VectorSix/HF-ICT_IoT_Switcher/README.md

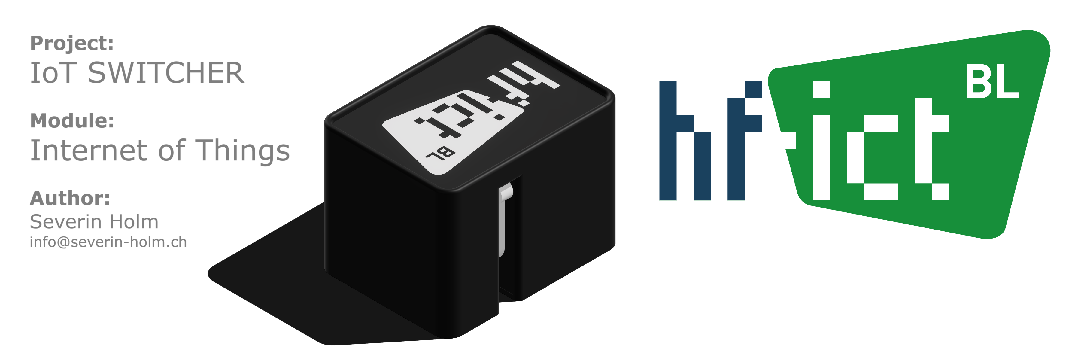
[picture p1: images/Git_Logo.png]
GitHub_Readme_Logo
