VectorSix/HF-ICT_IoT_Switcher/documentation/GitRepo.docx

SWITCHER

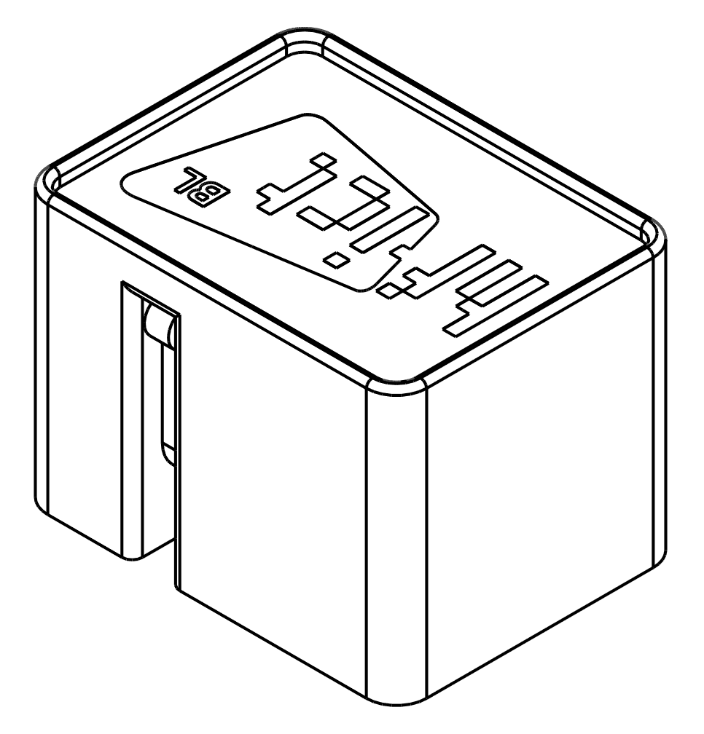
[picture p2: figure]

Scan code for instructions

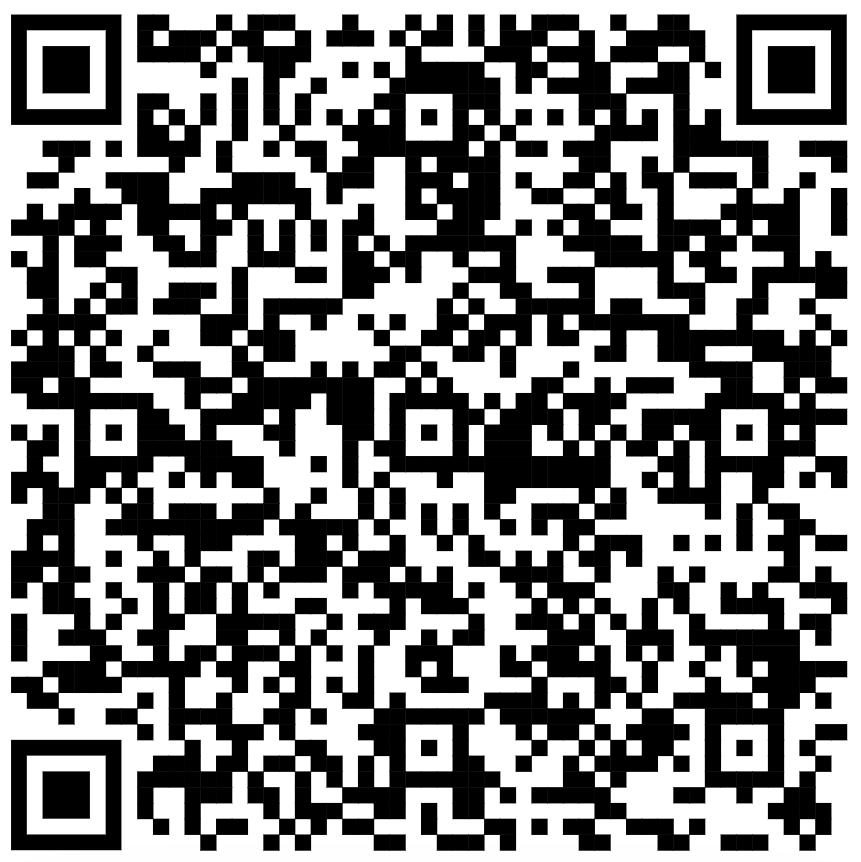
[picture p3: figure]

https://github.com/VectorSix/HF-ICT_IoT_Switcher

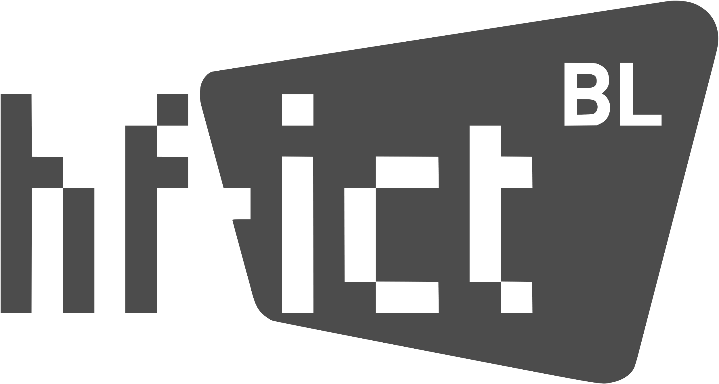
[picture p4: figure]

2025 BY SEVERIN HOLM – HF-ICT – IOT 2 BUILD MANUAL V.1.0
