VectorSix/HF-ICT_IoT_Switcher/flasher/assets/devices/iot_switcher/product.png

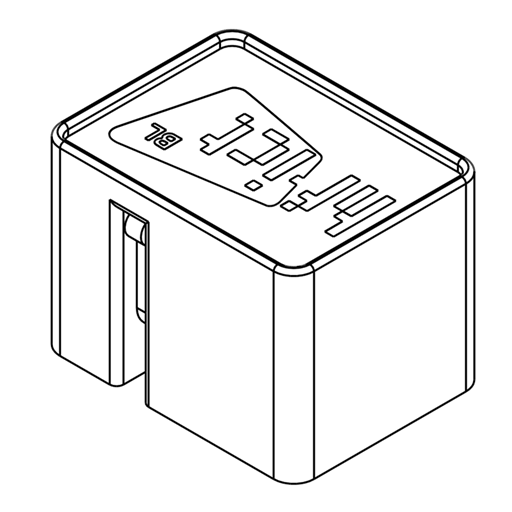
flasher/assets/devices/iot_switcher/product.png
