VectorSix/HF-ICT_IoT_Switcher/images/Case.png

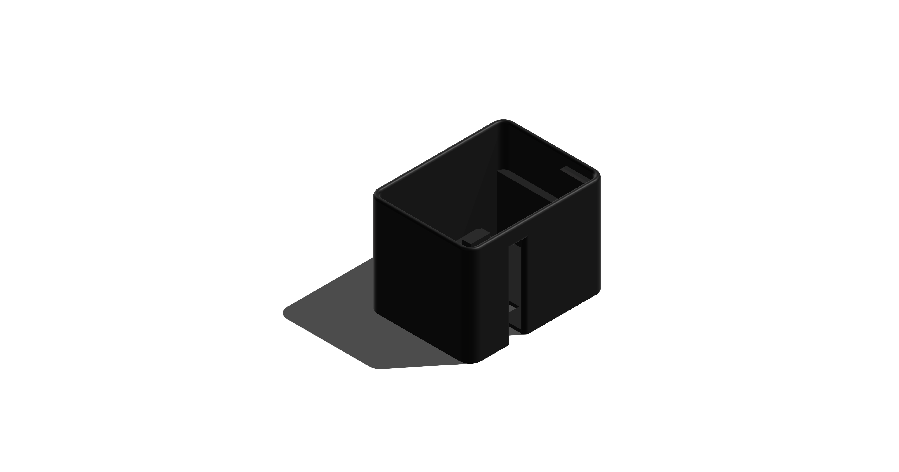
images/Case.png
