VectorSix/HF-ICT_IoT_Switcher/images/Closer.png

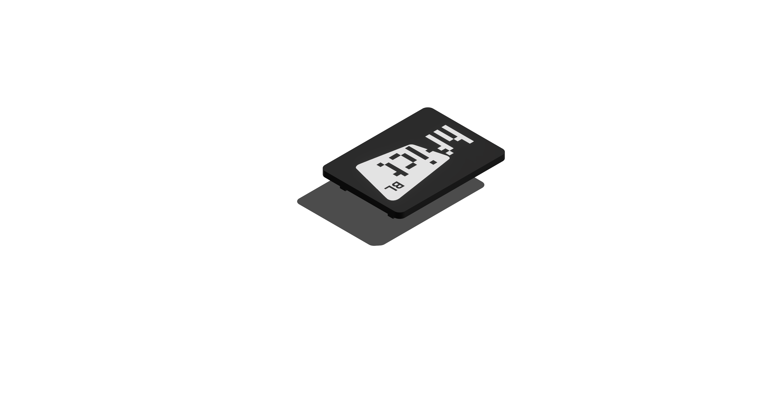
images/Closer.png
