VectorSix/HF-ICT_IoT_Switcher/images/Finger.png

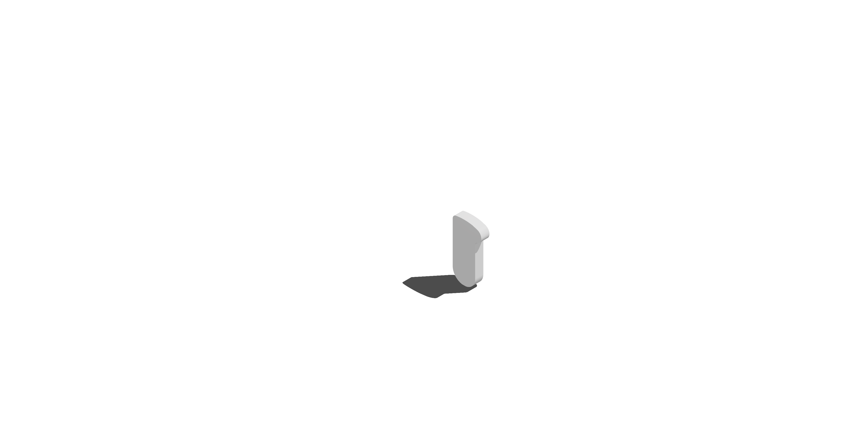
images/Finger.png
