VectorSix/HF-ICT_IoT_Switcher/images/OPEN_0.png

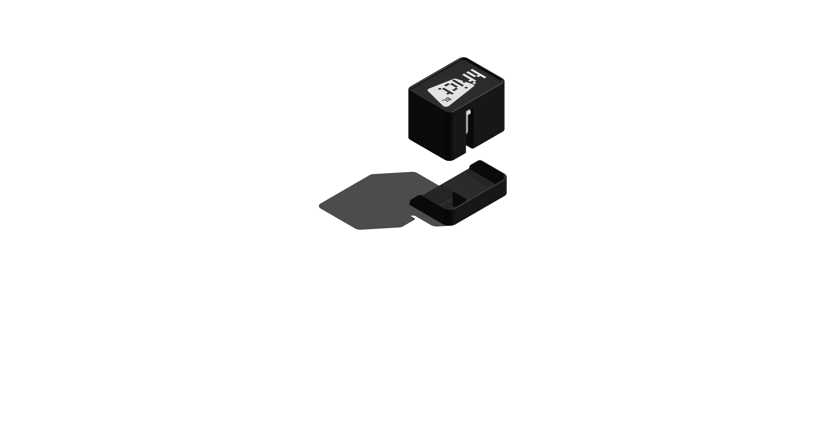
images/OPEN_0.png
