VectorSix/HF-ICT_IoT_Switcher/images/OPEN_1.png

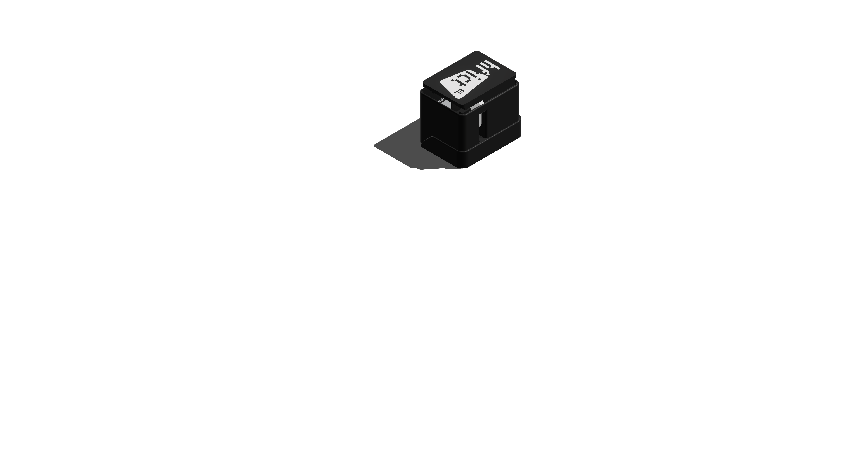
images/OPEN_1.png
