VectorSix/HF-ICT_IoT_Switcher/images/Opener_Tool.png

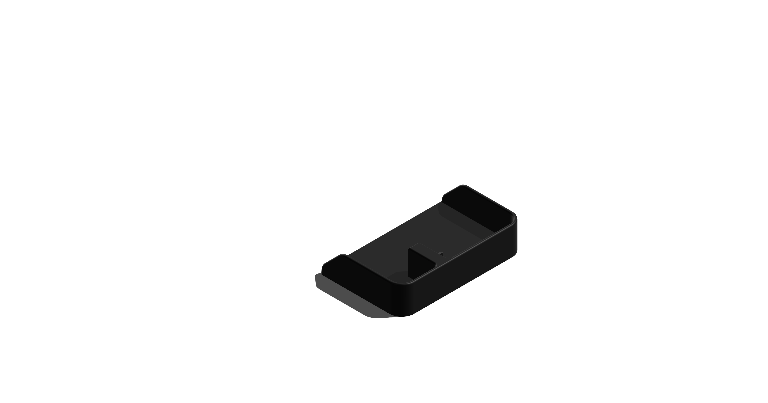
images/Opener_Tool.png
