VectorSix/HF-ICT_IoT_Switcher/images/Servo_Mount.png

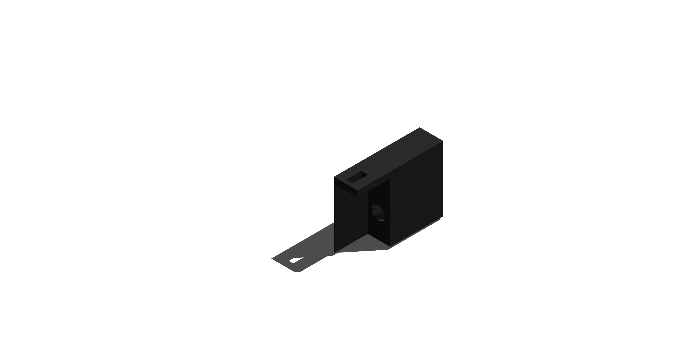
images/Servo_Mount.png
