VectorSix/HF-ICT_IoT_Switcher/3D-Print/IoT-Switcher.3mf

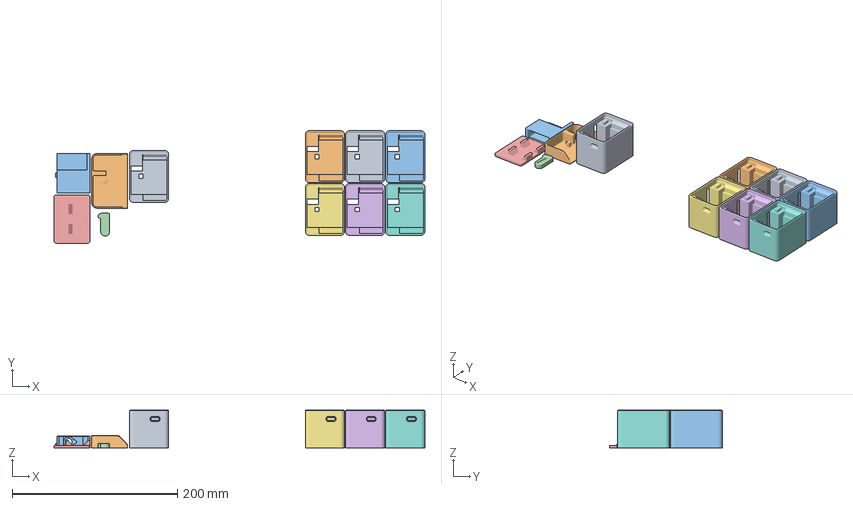
[picture p13: CAD file, 2025-08-30]
3D-Print/IoT-Switcher.3mf
448.8 x 136.3 x 45.6 mm
Case x 7
K_rper_07
Servo_Mount
Finger
Closer
