VectorSix/HF-ICT_IoT_Switcher/images/STEP_0.png

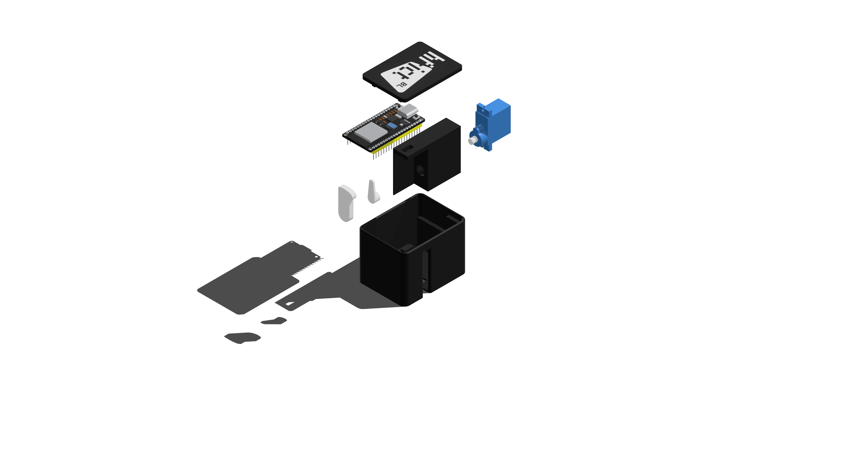
images/STEP_0.png
