VectorSix/HF-ICT_IoT_Switcher/images/STEP_3.png

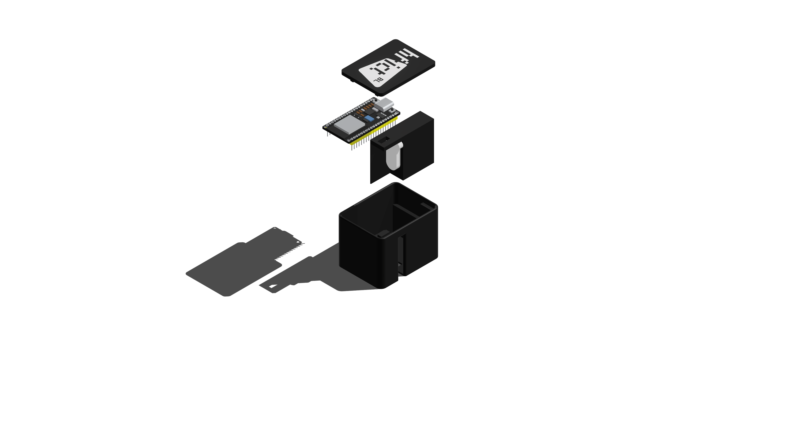
images/STEP_3.png
