VectorSix/HF-ICT_IoT_Switcher/firmware/webpages.h

#pragma once

/*
// Neutral WiFi Logo
const char svg_logo[] PROGMEM = R"rawliteral(
<svg xmlns="http://www.w3.org/2000/svg" viewBox="0 0 200 200">
    <circle cx="100" cy="100" r="80" fill="#3b82f6"/>
    <text x="100" y="115" font-size="45" text-anchor="middle" fill="white">WiFi</text>
</svg>
)rawliteral";
*/

// HF-ICT Logo
const char svg_logo[] PROGMEM = R"rawliteral(
  <svg xmlns="http://www.w3.org/2000/svg" viewBox="0 0 1303 697" version="1.1">
    <path d="M 0 369.500 L 0 568 29 568 L 58 568 58 454.500 L 58 341 86 341 L 114 341 114 454.500 L 114 568 142.500 568 L 171 568 171 454.500 L 171 341 142.500 341 L 114 341 114 312.500 L 114 284 86 284 L 58 284 58 227.500 L 58 171 29 171 L 0 171 0 369.500 M 284 199.500 L 284 228 255.500 228 L 227 228 227 398 L 227 568 255.496 568 L 283.991 568 284.246 454.750 L 284.500 341.500 312.750 341.234 L 341 340.969 341 312.484 L 341 284 312.500 284 L 284 284 284 256 L 284 228 312.500 228 L 341 228 341 199.500 L 341 171 312.500 171 L 284 171 284 199.500" stroke="none" fill="#3682B0" fill-rule="evenodd"/><path d="M 1215 0.655 C 1188.079 4.293, 388.080 128.350, 384.440 129.452 C 368.288 134.338, 358.542 156.457, 361.946 180.500 C 362.569 184.900, 372.405 222.925, 383.803 265 L 404.526 341.500 429.263 341.767 L 454 342.035 454 369.517 L 454 397 437 397 C 427.650 397, 420 397.400, 420 397.888 C 420 400.356, 461.131 550.356, 462.585 553.191 C 468.376 564.486, 478.442 574.883, 488.914 580.385 C 496.139 584.182, 498.148 584.587, 785.844 640.268 L 1075.500 696.329 1090.500 696.327 C 1102.703 696.326, 1106.952 695.928, 1113.287 694.194 C 1129.528 689.749, 1144.111 679.545, 1149.593 668.789 C 1152.964 662.176, 1300.576 91.152, 1302.051 79.019 C 1304.608 57.993, 1298.598 38.321, 1285.196 23.845 C 1271.460 9.009, 1253.444 1.487, 1229.500 0.593 C 1223.450 0.367, 1216.925 0.395, 1215 0.655 M 1024 170.556 L 1024 227.111 1053.250 226.806 C 1080.661 226.519, 1082.791 226.366, 1087.122 224.363 C 1098 2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
      width: 100%;
      margin-top: 8px;
      padding: 10px;
      border: 1px solid #d1d5db;
      border-radius: 8px;
      font-size: 16px;
      box-sizing: border-box;
    }
    select {
      appearance: none;
      -webkit-appearance: none;
      -moz-appearance: none;
      background: #fff url('data:image/svg+xml;utf8,<svg xmlns="http://www.w3.org/2000/svg" width="14" height="14" fill="none" stroke="%23374151" stroke-width="2" stroke-linecap="round" stroke-linejoin="round"><polyline points="2 5 7 10 12 5"/></svg>') no-repeat right 12px center;
      background-size: 14px;
      padding-right: 32px;
      cursor: pointer;
    }
    button {
      margin-top: 20px;
      background: #3b82f6;
      color: #fff;
      font-weight: 600;
      border: none;
      cursor: pointer;
      padding: 12px;
    }
    .footer {
      margin-top: 20px;
      text-align: center;
      padding: 10px;
      font-size: 14px;
      color: #6b7280;
      width: 100%;
      background: transparent;
    }
    .footer .heart {
      color: #e11d48;
    }
    @media (prefers-color-scheme: dark){
      body{background:#111827;color:#f9fafb;}
      .container{background:#1f2937;}
      h2{color:#f9fafb;}
      label{color:#d1d5db;}
      select,
      input[type=text],
      input[type=password]{
        background:#111827;
        color:#f9fafb;
        border:1px solid #374151;
      }
      select {
        background:#111827 url('data:image/svg+xml;utf8,<svg xmlns="http://www.w3.org/2000/svg" width="14" height="14" fill="none" stroke="%23d1d5db" stroke-width="2" stroke-linecap="round" stroke-linejoin="round"><polyline points="2 5 7 10 12 5"/></svg>') no-repeat right 12px center;
        background-size:14px;
      }
      button{background:#2563eb;}
      .footer {color:#9ca3af;}
    }
  </style>
</head>
<body>
  <div class="container">
    <div class="logo">
      %SVG_LOGO%
    </div>

    <h2>WLAN konfigurieren</h2>
    <form action="/save" method="POST">
      <label for="device">Device Name</label>
      <input type="text" id="device" name="device" placeholder="Name des Geräts" minlength="5" maxlength="64" required>
      <label for="ssid">SSID auswählen</label>
      <select name="ssid" id="ssid">
        %SSID_OPTIONS%
      </select>
      <label for="pass">Passwort</label>
      <input type="password" id="pass" name="pass" placeholder="WLAN Passwort">
      <button type="submit">💾 Speichern</button>
    </form>
  </div>

  <div class="footer">
    Made with <span class="heart">♥</span> by Severin Holm (2025 hf-ict - IoT)
  </div>
</body>
</html>
)rawliteral";


// Captive Portal Save
const char saved_html[] PROGMEM = R"rawliteral(
<!DOCTYPE html>
<html lang="de">
<head>
  <meta charset="UTF-8">
  <meta name="viewport" content="width=device-width, initial-scale=1.0">
  <title>WiFi Setup – Gespeichert</title>
  <style>
    html, body {
      margin: 0;
      padding: 0;
      height: 100%;
      width: 100%;
      font-family: Arial, sans-serif;
      background: #f3f4f6;
      overflow: hidden;
      display: flex;
      justify-content: center;
      align-items: center;
      flex-direction: column;
    }
    .container {
      max-width: 400px;
      width: 100%;
      padding: 40px;
      background: #fff;
      border-radius: 16px;
      box-shadow: 0 8px 20px rgba(0,0,0,0.1);
      text-align: center;
      animation: fadein 0.5s ease-out;
      box-sizing: border-box;
    }
    .logo {
      width: 80%;
      max-width: 300px;
      margin: 0 auto 15px;
    }
    .success-icon {
      font-size: 60px;
      color: #10b981;
      margin-bottom: 20px;
      animation: pop 0.5s ease-out;
    }
    h2 {
      color: #111827;
      margin-bottom: 20px;
      animation: fadein 0.6s ease-out;
    }
    p {
      color: #374151;
      font-size: 16px;
      margin-bottom: 20px;
      animation: fadein 0.6s ease-out 0.2s;
    }
    .footer {
      margin-top: 20px;
      text-align: center;
      padding: 10px;
      font-size: 14px;
      color: #6b7280;
      background: transparent;
    }
    .footer .heart {color: #e11d48;}

    @keyframes pop {
      0% { transform: scale(0); opacity:0; }
      70% { transform: scale(1.2); opacity:1; }
      100% { transform: scale(1); }
    }
    @keyframes fadein {
      0% { opacity:0; transform: translateY(-10px); }
      100% { opacity:1; transform: translateY(0); }
    }

    @media (prefers-color-scheme: dark){
      body{background: linear-gradient(135deg, #111827, #1f2937); color:#f9fafb;}
      .container{background:#1f2937;}
      h2{color:#f9fafb;}
      p{color:#d1d5db;}
      .footer{color:#9ca3af;}
    }

    @media (max-width:420px){
      .container { width:90%; padding:25px; }
      .success-icon { font-size:50px; }
      h2 { font-size:20px; }
      p { font-size:14px; }
    }
  </style>
</head>
<body>
  <div class="container" id="container">
    <div class="logo">%SVG_LOGO%</div>
    <div class="success-icon">✅</div>
    <h2>Daten gespeichert</h2>
    <p>Der ESP32 startet nun neu und verbindet sich mit deinem WLAN.<br>Neustart in <span id="countdown">10</span> Sekunden...</p>
  </div>
  <div class="footer">
    Made with <span class="heart">♥</span> by Severin Holm (2025 hf-ict - IoT)
  </div>

  <script>
    let sec = 10;
    const countdown = document.getElementById('countdown');
    const container = document.getElementById('container');

    const interval = setInterval(() => {
      sec--;
      countdown.textContent = sec;
      if(sec <= 0) {
        clearInterval(interval);
        container.innerHTML = `
          <div class="success-icon">🎉</div>
          <h2>Konfiguration abgeschlossen!</h2>
          <p>Bitte loggen Sie sich wieder in das korrekte WiFi-Netz ein.</p>
        `;
      }
    }, 1000);
  </script>
</body>
</html>
)rawliteral";

const char app_html[] PROGMEM = R"rawliteral(
<!DOCTYPE html>
<html lang="de">
<head>
  <meta charset="UTF-8">
  <meta name="viewport" content="width=device-width, initial-scale=1.0">
  <title>ESP32 Steuerung</title>
  <style>
    html, body {
      height:100%;
      margin:0;
      padding:0;
      overflow:hidden;
    }
    body {
      font-family: Arial, sans-serif;
      background:#f3f4f6;
      display:flex;
      justify-content:center;
      align-items:center;
      flex-direction:column;
    }
    .container {
      width:400px;
      max-width:95%;
      padding:40px;
      background:#fff;
      border-radius:16px;
      box-shadow:0 8px 20px rgba(0,0,0,0.1);
      text-align:center;
      box-sizing:border-box;
    }
    .logo {
      width:80%;
      max-width:300px;
      margin:0 auto 15px;
    }
    .device-name {
      font-size:22px;
      color:#374151;
      margin-bottom:25px;
      text-align:center;
      user-select:none;
    }
    h2 { font-size:20px; margin-bottom:15px; }
    .btn-row {
      display:flex;
      gap:15px;
      margin-bottom:40px;
    }
    .btn-row button {
      flex:1;
      aspect-ratio:1/1;
      font-size:18px;
      border:none;
      border-radius:16px;
      background:linear-gradient(145deg, #3b82f6, #2563eb);
      color:white;
      cursor:pointer;
      box-shadow:0 6px 12px rgba(0,0,0,0.15);
      transition:transform 0.1s, box-shadow 0.2s, filter 0.2s;
      user-select:none;
      -webkit-touch-callout:none;
    }
    .btn-row button:active {
      transform:scale(0.95);
      box-shadow:0 4px 8px rgba(0,0,0,0.2);
      filter:brightness(1.1);
    }
    .btn-row button:hover { filter:brightness(1.05); }
    button.button-active { animation: blink 0.5s infinite; }
    #btnReset {
      display:block;
      width:100%;
      padding:15px;
      margin:20px 0 0 0;
      border:1px solid #d1d5db;
      border-radius:12px;
      background:#f3f3f3;
      color:#555;
      cursor:pointer;
      font-size:16px;
      opacity:0.9;
      transition:transform 0.1s, opacity 0.2s, filter 0.2s;
      user-select:none;
    }
    #btnReset:active { transform:scale(0.95); opacity:1; }
    #btnReset:hover { filter:brightness(1.05); }
    .confirm-container {
      text-align:center;
      display:none;
      position:relative;
    }
    .confirm-container p {
      margin-bottom:25px;
      color:#374151;
      text-align:center;
    }
    .btn-confirm {
      width:100%;
      padding:15px;
      border:none;
      border-radius:12px;
      background:#ef4444;
      color:white;
      font-size:16px;
      cursor:pointer;
      margin-bottom:10px;
      transition:filter 0.2s;
    }
    .btn-confirm:hover { filter:brightness(1.1); }
    .btn-cancel {
      width:100%;
      padding:15px;
      border:none;
      border-radius:12px;
      background:#3b82f6;
      color:white;
      font-size:16px;
      cursor:pointer;
      transition:filter 0.2s;
    }
    .btn-cancel:hover { filter:brightness(1.05); }
    @keyframes blink { 0%,100%{opacity:1;} 50%{opacity:0.5;} }
    .footer {
      margin-top:30px;
      text-align:center;
      font-size:14px;
      color:#6b7280;
      background:transparent;
    }
    .footer .heart {color:#e11d48;}
    .success-icon {
      font-size:50px;
      color:#facc15;
      margin-bottom:20px;
      animation:pulse 1s ease-in-out infinite;
    }
    @keyframes pulse { 0%,100%{transform:scale(1);} 50%{transform:scale(1.2);} }
    @media (prefers-color-scheme: dark){
      body{background:#111827;color:#f9fafb;}
      .container{background:#1f2937;}
      .device-name{color:#d1d5db;}
      #btnReset{background:#1f2937;color:#d1d5db;border:1px solid #374151;}
      .confirm-container p{color:#d1d5db;}
      .btn-cancel{background:#2563eb;}
      .footer{color:#9ca3af;}
    }
    @media (max-width:420px){
      .container{width:90%;padding:25px;}
      .btn-row button, #btnReset{font-size:16px;padding:12px;}
    }
  </style>
</head>
<body>
  <div class="container" id="button-container">
    <div class="logo">%SVG_LOGO%</div>
    <div class="device-name">%DEVICE_NAME%</div>

    <div class="main-buttons">
      <div class="btn-row">
        <button id="btn90" aria-label="Bewege Servo auf 90 Grad">90°</button>
        <button id="btn180" aria-label="Bewege Servo auf 180 Grad">180°</button>
      </div>
      <button id="btnReset">Reset</button>
    </div>

    <div class="confirm-container" id="confirm-container">
      <h2>Gerät zurücksetzen!</h2>
      <p>Sind Sie sicher, dass Sie das Gerät zurücksetzen möchten? Nach einem Reset muss dieses Gerät neu eingerichtet werden.</p>
      <button class="btn-confirm" id="confirm-reset">Akzeptieren</button>
      <button class="btn-cancel" id="cancel-reset">Abbrechen</button>
    </div>
  </div>

  <div class="footer">
    Made with <span class="heart">♥</span> by Severin Holm (2025 hf-ict - IoT)
  </div>

  <script>
    const btn90 = document.getElementById('btn90');
    const btn180 = document.getElementById('btn180');
    const btnReset = document.getElementById('btnReset');
    const container = document.getElementById('button-container');
    const mainButtons = document.querySelector('.main-buttons');
    const confirmContainer = document.getElementById('confirm-container');
    const confirmReset = document.getElementById('confirm-reset');
    const cancelReset = document.getElementById('cancel-reset');

    function setupButton(button, actionDown, actionUp) {
      function pressDown() {
        fetch('/cmd?action=' + actionDown);
        button.classList.add('button-active');
      }
      function pressUp() {
        fetch('/cmd?action=' + actionUp);
        button.classList.remove('button-active');
      }
      button.addEventListener('mousedown', pressDown);
      button.addEventListener('touchstart', pressDown);
      button.addEventListener('mouseup', pressUp);
      button.addEventListener('touchend', pressUp);
      button.addEventListener('mouseleave', pressUp);
      button.addEventListener('contextmenu', e => e.preventDefault());
    }

    setupButton(btn90, 'pos_90', 'pos_0');
    setupButton(btn180, 'pos_180', 'pos_0');

    btnReset.addEventListener('click', () => {
      mainButtons.style.display = 'none';
      confirmContainer.style.display = 'block';
      document.querySelector('.device-name').style.display = 'none';
    });
    cancelReset.addEventListener('click', () => {
      confirmContainer.style.display = 'none';
      mainButtons.style.display = 'block';
      document.querySelector('.device-name').style.display = 'block';
    });
    confirmReset.addEventListener('click', () => {
      fetch('/reset').then(() => {
        container.innerHTML = `
          <div class="success-icon">⚠️</div>
          <h2>Gerät wurde zurückgesetzt!</h2>
          <p>Das Gerät muss neu eingerichtet werden.</p>
        `;
      });
    });
  </script>
</body>
</html>
)rawliteral";
