VectorSix/HF-ICT_IoT_Switcher/(commit log)

2025-08-29 Version 1.0
    initial Checkin
    [IoT-Switcher.3mf]
2025-08-30 Remove Blynk Cloud Code and Adding PWA Code instead.
    [IoT-Switcher.3mf]
2025-08-30 Rebuild
    - Remove PWA
    - Adding Device APP
2025-08-31 Mayor FineTuning
    - Adding WebFlasher
    - UI Fixes in HTML App
    - AP Bugfix when using Client Mode (terminate AP correctly)
    [WiFiManagerESP32.cpp, webpages.h]
2025-09-03 Finish Manual
    - Correction
    - Adding Arduino part
